jamesrosssharp/OLED_DEV_BOARD/README.md

OLED DEV BOARD
==============

A simple dev board to break out an OLED, PWM sound, buttons, PSRAM
and QSPI flash for making games with iCE40 development boards
