jamesrosssharp/OLED_DEV_BOARD/OLED_DEV_BOARD/OLED_DEV_BOARD.kicad_pcb

## KiCad design OLED_DEV_BOARD/OLED_DEV_BOARD.kicad_pcb (2025-01-19)

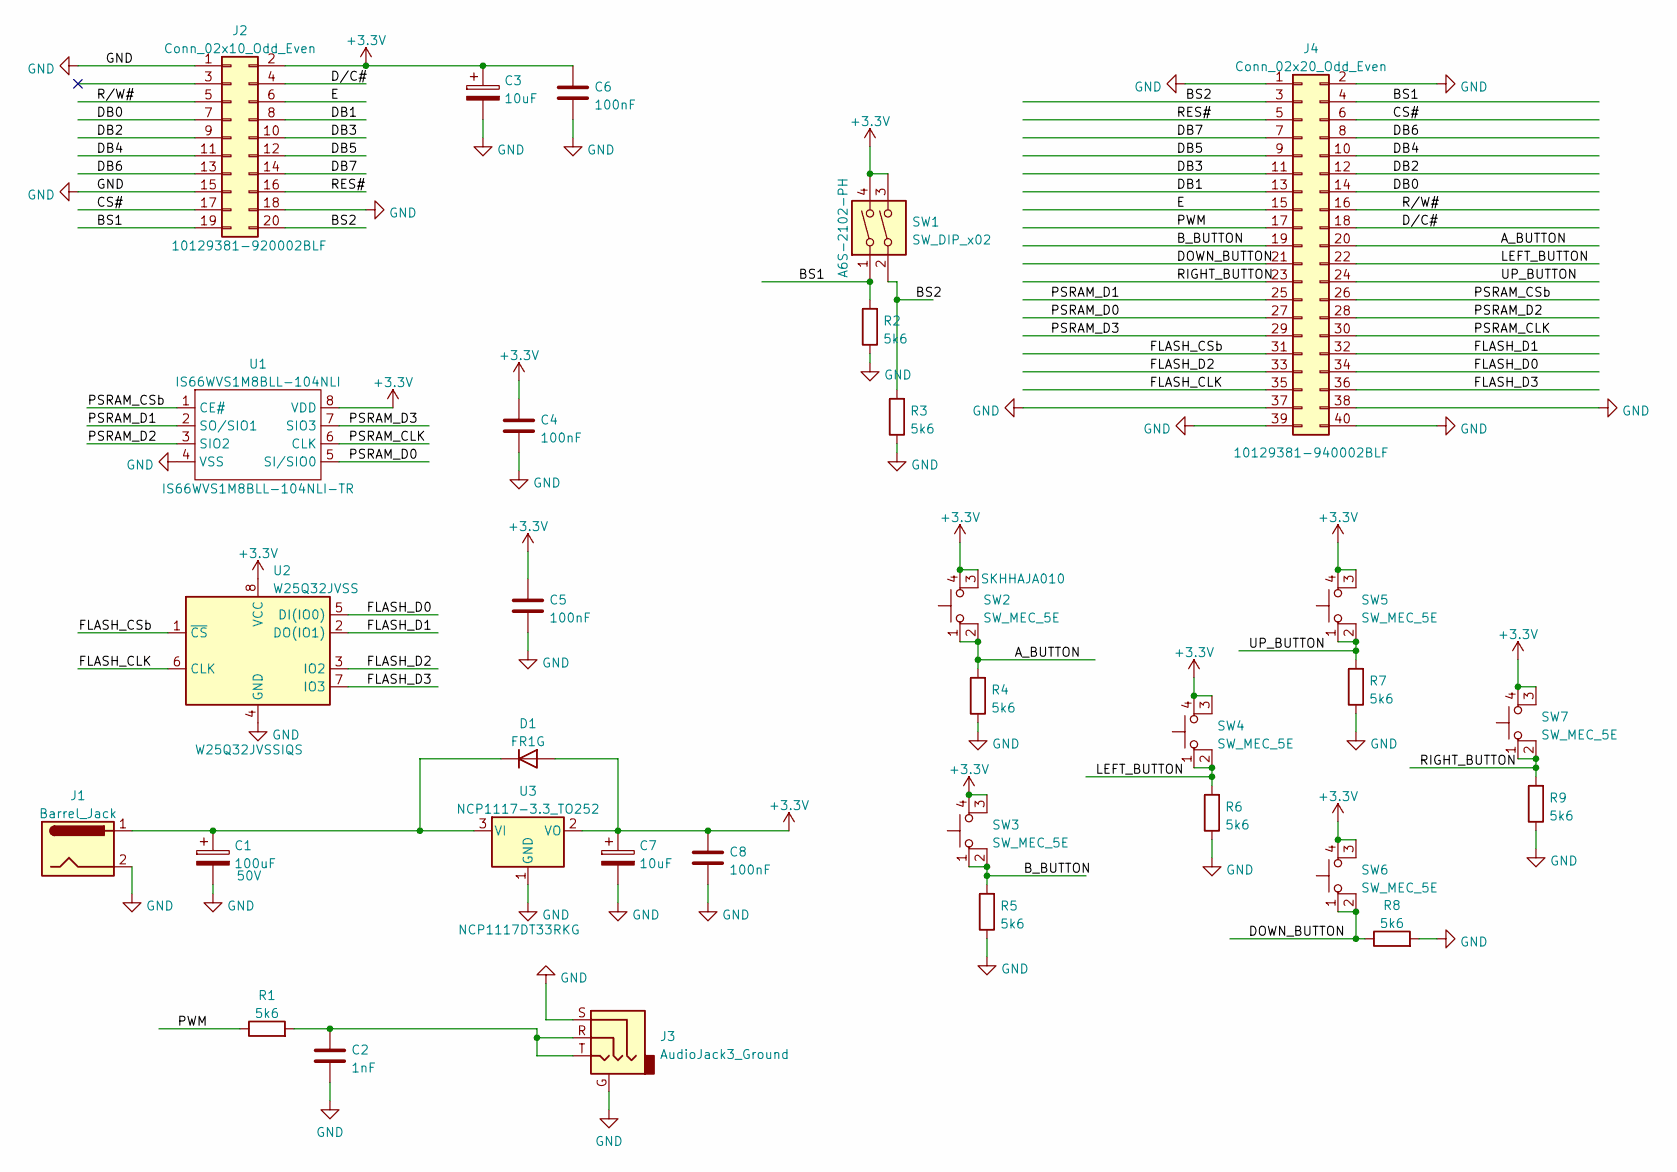
[picture p1: schematic OLED_DEV_BOARD.kicad_sch]

Parts:
C1: 100uF; CP_Elec_10x10; Voltage 50V; Manufacturer Part Number GXC1H101MCQ1GS; Mouser Part Number 647-GXC1H101MCQ1GS
C2: 1nF; C_0603_1608Metric; Manufacturer Part Number C0603C102K4RAC7411; Mouser Part Number 80-C0603C102K4RACLR
C3, C7: 10uF; C_1206_3216Metric; Manufacturer Part Number CL31B106KQHNFNE; Mouser Part Number 187-CL31B106KQHNFNE
C4, C5, C6, C8: 100nF; C_0603_1608Metric; Manufacturer Part Number C0603C104K4RACTU; Mouser Part Number 80-C0603C104K4R
D1: FR1G; D_DO-41_SOD81_P10.16mm_Horizontal; Manufacturer Part Number FR1G; Mouser Part Number 637-FR1G
J1: Barrel_Jack; BarrelJack_CUI_PJ-102AH_Horizontal; Manufacturer Part Number PJ-102AH; Mouser Part Number 490-PJ-102AH
J2: Conn_02x10_Odd_Even; NHD-1.8-160128UBC3; Mouser Part Number 649-1012938192002BLF
J3: AudioJack3_Ground; Jack_3.5mm_CUI_SJ-3523-SMT_Horizontal; MPN SJ-3523-SMT-TR; Mouser Part Number 490-SJ-3523-SMT-TR
J4: Conn_02x20_Odd_Even; PinHeader_2x20_P2.54mm_Vertical; Manufacturer Part Number 10129381-940002BLF; Mouser Part Number 649-1012938194002BLF
R1, R2, R3, R4, R5, R6, R7, R8, R9: 5k6; R_0603_1608Metric; Manufacturer Part Number AC0603FR-075K6L; Mouser Part Number 603-AC0603FR-075K6L
SW1: SW_DIP_x02; SW_DIP_SPSTx02_Slide_Omron_A6S-210x_W8.9mm_P2.54mm; Manufacturer Part Number A6S-2102-PH; Mouser Part Number 653-A6S-2102-PH
SW2, SW3, SW4, SW5, SW6, SW7: SW_MEC_5E; SKHHAJA010; Manufacturer Part Number SKHHAJA010; Mouser Part Number 688-SKHHAJ
U1: IS66WVS1M8BLL-104NLI; SOIC-8_5.23x5.23mm_P1.27mm; Manufacturer Part Number IS66WVS1M8BLL-104NLI-TR; Mouser Part Number 870-WVS1M8BLL104NLIT
U2: W25Q32JVSS; SOIC-8_5.23x5.23mm_P1.27mm; Manufacturer Part Number W25Q32JVSSIQS; Mouser Part Number 454-W25Q32JVSSIQS
U3: NCP1117-3.3_TO252; TO-252-2; Manufacturer Part Number NCP1117DT33RKG; Mouser Part Number 863-NCP1117DT33RKG

Connections:
+3V3: C3.1, C4.1, C5.1, C6.1, C7.1, C8.1, D1.2 (A), J2.2, SW1.3, SW1.4, SW2.3 (K), SW2.4 (A), SW3.3 (K), SW3.4 (A), SW4.3 (K), SW4.4 (A), SW5.3 (K), SW5.4 (A), SW6.3 (K), SW6.4 (A), SW7.3 (K), SW7.4 (A), U1.8 (VDD), U2.8 (VCC), U3.2 (VO)
/A_BUTTON: J4.20, R4.2, SW2.1, SW2.2
/BS1: J2.19, J4.4, R2.2, SW1.1
/BS2: J2.20, J4.3, R3.2, SW1.2
/B_BUTTON: J4.19, R5.2, SW3.1, SW3.2
/CS#: J2.17, J4.6
/DB0: J2.7, J4.14
/DB1: J2.8, J4.13
/DB2: J2.9, J4.12
/DB3: J2.10, J4.11
/DB4: J2.11, J4.10
/DB5: J2.12, J4.9
/DB6: J2.13, J4.8
/DB7: J2.14, J4.7
/DOWN_BUTTON: J4.21, R8.1, SW6.1, SW6.2
/D/C#: J2.4, J4.18
/E: J2.6, J4.15
/FLASH_CLK: J4.35, U2.6 (CLK)
/FLASH_CSb: J4.31, U2.1 (~CS)
/FLASH_D0: J4.34, U2.5 (DI(IO0))
/FLASH_D1: J4.32, U2.2 (DO(IO1))
/FLASH_D2: J4.33, U2.3 (IO2)
/FLASH_D3: J4.36, U2.7 (IO3)
/LEFT_BUTTON: J4.22, R6.2, SW4.1, SW4.2
/PSRAM_CLK: J4.30, U1.6 (CLK)
/PSRAM_CSb: J4.26, U1.1 (CE#)
/PSRAM_D0: J4.27, U1.5 (SI/SIO0)
/PSRAM_D1: J4.25, U1.2 (SO/SIO1)
/PSRAM_D2: J4.28, U1.3 (SIO2)
/PSRAM_D3: J4.29, U1.7 (SIO3)
/PWM: J4.17, R1.1
/RES#: J2.16, J4.5
/RIGHT_BUTTON: J4.23, R9.2, SW7.1, SW7.2
/R/W#: J2.5, J4.16
/UP_BUTTON: J4.24, R7.2, SW5.1, SW5.2
GND: C1.2, C2.2, C3.2, C4.2, C5.2, C6.2, C7.2, C8.2, J1.2, J2.1, J2.15, J2.18, J3.G, J3.S, J4.1, J4.2, J4.37, J4.38, J4.39, J4.40, R2.1, R3.1, R4.1, R5.1, R6.1, R7.1, R8.2, R9.1, U1.4 (VSS), U2.4 (GND), U3.1 (GND)
unnamed: C1.1, D1.1 (K), J1.1, U3.3 (VI)
unnamed: C2.1, J3.R, J3.T, R1.2

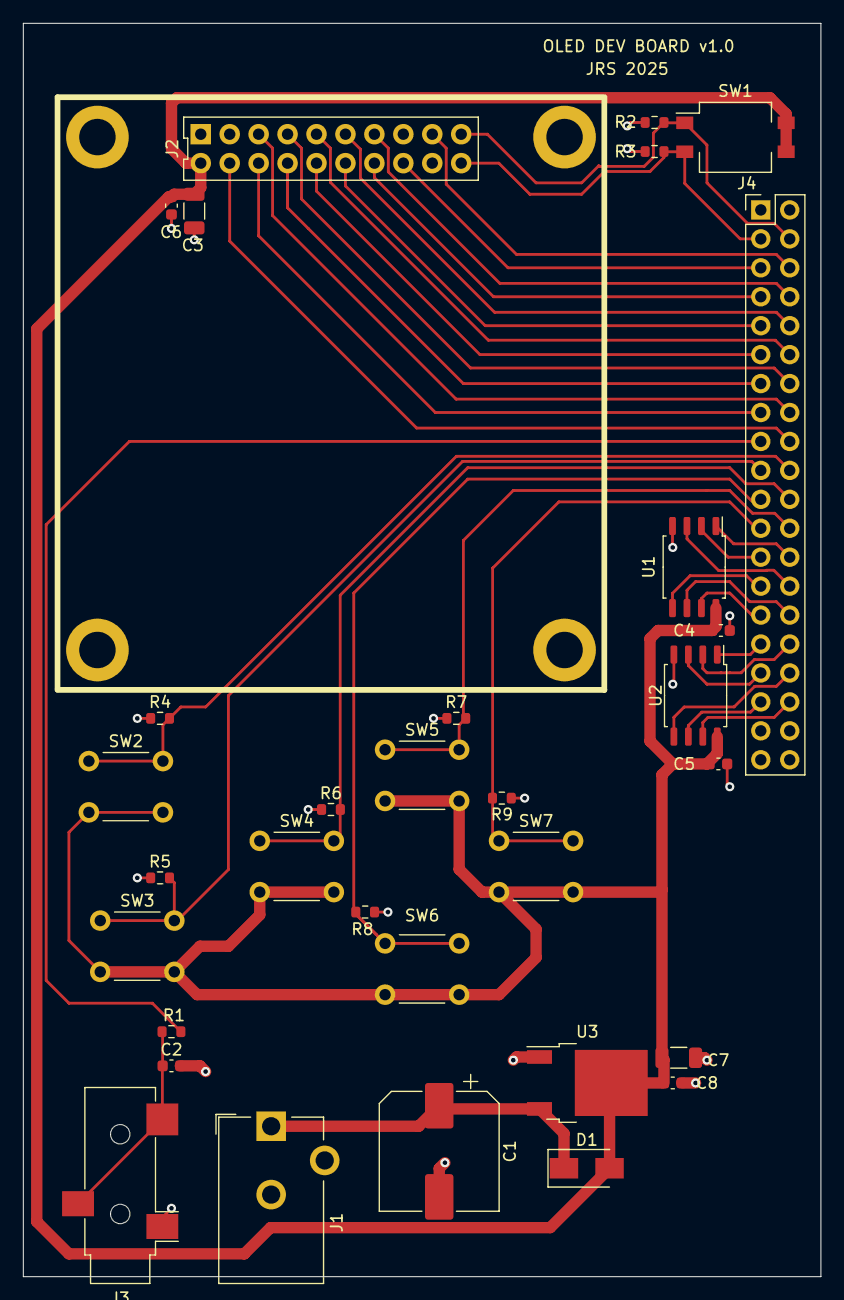
[picture p2: board OLED_DEV_BOARD.kicad_pcb from above]

Board: 2 copper layers, 70.0 x 110.0 mm, 32 parts (0 on the bottom side), 38 nets.
