jamesrosssharp/OLED_DEV_BOARD/BRINGUP_FIRMWARE/06-FLASH-OLED/README.md

Flash + OLED Test
=================

Goals:

1) Make a python script to generate an animated cube as 16-bit, 160 x 128 pixels

2) Write a C-program and accompanying bitstream to write the cube animation into flash

3) Write RTL to read the animation from QSPI flash and stream to OLED @ 60 Hz
