jamesrosssharp/OLED_DEV_BOARD/(commit log)

2025-01-12 Added some parts
    [OLED_DEV_BOARD.kicad_sch]
2025-01-12 Added switches
    [OLED_DEV_BOARD.kicad_sch]
2025-01-12 Added signals to connector
    [OLED_DEV_BOARD.kicad_sch]
2025-01-13 Added part number to header
    [OLED_DEV_BOARD.kicad_sch]
2025-01-14 Added part numbers and footprints
    [OLED_DEV_BOARD.kicad_pcb, OLED_DEV_BOARD.kicad_sch]
2025-01-14 Added proper footprint for OLED module and placed components roughly
    [OLED_DEV_BOARD.kicad_pcb, OLED_DEV_BOARD.kicad_sch]
2025-01-16 Made board smaller
    [OLED_DEV_BOARD.kicad_pcb, OLED_DEV_BOARD.kicad_sch]
2025-01-17 Changed ordering of pins for display so it would route better
    [OLED_DEV_BOARD.kicad_pcb, OLED_DEV_BOARD.kicad_sch]
2025-01-17 Mostly routed
    [OLED_DEV_BOARD.kicad_pcb, OLED_DEV_BOARD.kicad_sch]
2025-01-19 Added Fab Outputs
    [OLED_DEV_BOARD-B_Cu.gbr, OLED_DEV_BOARD-B_Mask.gbr, OLED_DEV_BOARD-B_Paste.gbr, OLED_DEV_BOARD-B_Silkscreen.gbr, OLED_DEV_BOARD-Edge_Cuts.gbr, OLED_DEV_BOARD-F_Cu.gbr, OLED_DEV_BOARD-F_Mask.gbr, OLED_DEV_BOARD-F_Paste.gbr]
2025-01-19 Committed changes
    [OLED_DEV_BOARD.kicad_pcb]
2025-01-19 Added BOM
    [BOM.csv, BOM.ods]
